Crisha-Pablo/Egal/gridfinity-rasierset/bilder/uebersicht.png

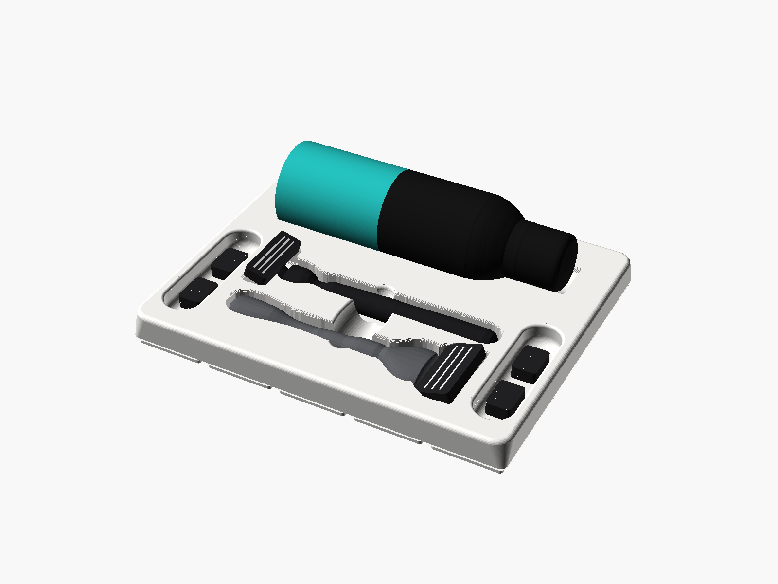
gridfinity-rasierset/bilder/uebersicht.png
