Crisha-Pablo/Egal/gridfinity-rasierset/stl/rasier_station_5x4x3u.stl

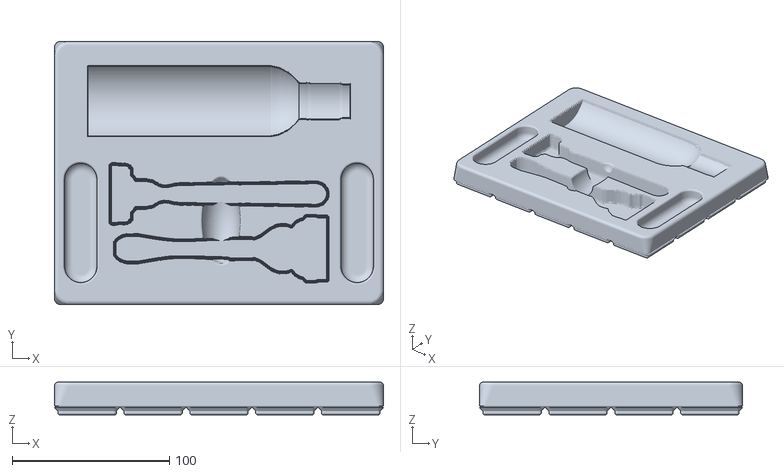
[picture p7: CAD file, 2026-10-03]
gridfinity-rasierset/stl/rasier_station_5x4x3u.stl
209.5 x 167.5 x 21.0
