Crisha-Pablo/Egal/gridfinity-rasierset/stl/passtest.stl

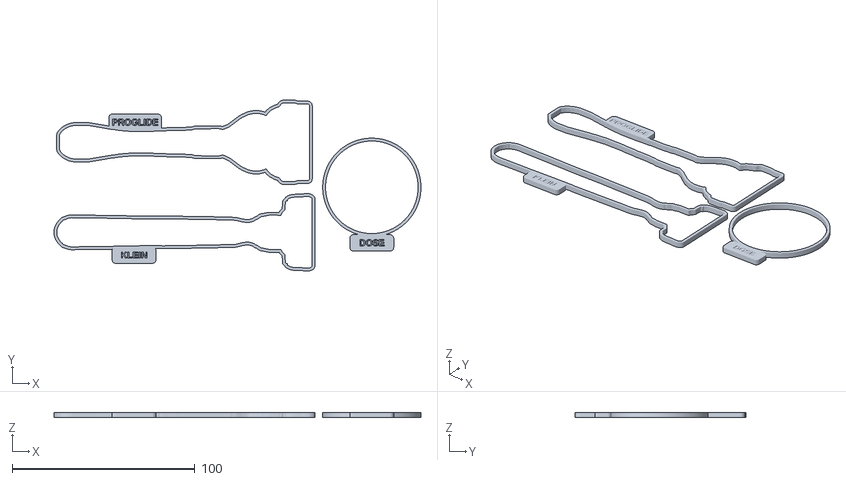
[picture p8: CAD file, 2026-10-03]
gridfinity-rasierset/stl/passtest.stl
200.8 x 93.5 x 3.00
