Crisha-Pablo/Egal/gridfinity-rasierset/umrisse.scad

// Automatisch erzeugt von werkzeug/fotos_vermessen.py. Nicht von Hand ändern.
// Alle Fotomaße gelten für 49 mm Dosendurchmesser, dose_d skaliert sie in OpenSCAD mit.

// Kleiner 3-Klingen-Rasierer aus IMG_8033: [Abstand vom Griffende, halbe Breite] in mm
bi_profil_mm = [
    [0.00, 0.00],
    [0.13, 1.66],
    [0.71, 3.02],
    [1.09, 3.68],
    [2.06, 4.92],
    [2.83, 5.52],
    [3.03, 5.97],
    [4.18, 6.32],
    [5.73, 6.94],
    [7.27, 7.17],
    [20.41, 6.93],
    [28.91, 6.88],
    [32.00, 6.74],
    [51.12, 6.45],
    [54.40, 6.53],
    [54.98, 6.41],
    [56.33, 6.41],
    [56.72, 6.58],
    [60.77, 6.50],
    [64.25, 6.54],
    [65.99, 6.42],
    [83.95, 6.15],
    [89.94, 5.96],
    [93.99, 5.99],
    [94.76, 5.86],
    [97.02, 5.76],
    [100.58, 4.87],
    [101.32, 4.81],
    [101.88, 4.64],
    [104.29, 4.55],
    [105.76, 4.90],
    [107.23, 5.37],
    [107.96, 5.76],
    [108.33, 6.16],
    [109.06, 6.35],
    [109.42, 6.55],
    [110.34, 7.20],
    [110.70, 7.33],
    [110.88, 7.60],
    [111.43, 7.86],
    [112.33, 7.92],
    [115.40, 8.56],
    [122.23, 8.52],
    [123.04, 10.19],
    [124.48, 11.71],
    [124.79, 11.89],
    [124.95, 16.31],
    [125.27, 16.32],
    [125.43, 16.46],
    [125.90, 16.49],
    [126.06, 17.50],
    [127.16, 18.07],
    [128.26, 18.34],
    [130.46, 18.50],
    [133.02, 18.52],
    [135.04, 18.75],
    [137.05, 18.73],
    [137.60, 18.50],
    [137.79, 18.33],
    [137.97, 18.33],
    [137.97, 0.00]];

bi_laenge_mm = 137.97;

// Rasierschaum-Dose aus IMG_8036: Länge / Durchmesser
dose_l_zu_d = 3.3429;

// Schulter und Kappe aus dem Produktbild: [Abstand von der Oberkante, Radius] in Dosendurchmessern
dose_oben = [
    [0.000, 0.088],
    [0.022, 0.265],
    [0.044, 0.299],
    [0.066, 0.314],
    [0.088, 0.319],
    [0.109, 0.321],
    [0.131, 0.321],
    [0.153, 0.321],
    [0.175, 0.321],
    [0.197, 0.321],
    [0.219, 0.321],
    [0.241, 0.321],
    [0.263, 0.321],
    [0.285, 0.321],
    [0.307, 0.321],
    [0.328, 0.321],
    [0.350, 0.321],
    [0.372, 0.321],
    [0.394, 0.321],
    [0.416, 0.321],
    [0.438, 0.321],
    [0.460, 0.321],
    [0.482, 0.321],
    [0.504, 0.325],
    [0.526, 0.325],
    [0.547, 0.323],
    [0.569, 0.323],
    [0.591, 0.323],
    [0.613, 0.323],
    [0.635, 0.325],
    [0.657, 0.347],
    [0.679, 0.365],
    [0.701, 0.381],
    [0.723, 0.398],
    [0.745, 0.412],
    [0.766, 0.425],
    [0.788, 0.436],
    [0.810, 0.445],
    [0.832, 0.456],
    [0.854, 0.464],
    [0.876, 0.473],
    [0.898, 0.480],
    [0.920, 0.485],
    [0.942, 0.489],
    [0.964, 0.493],
    [0.985, 0.496],
    [0.996, 0.500]];

// Gillette Fusion5 ProGlide aus dem Produktbild: [t, halbe Breite / Länge], t = 0 Griffende, 1 Kopfoberkante
pg_profil = [
    [0.0000, 0.0309],
    [0.0100, 0.0429],
    [0.0220, 0.0513],
    [0.0380, 0.0587],
    [0.0560, 0.0625],
    [0.1080, 0.0623],
    [0.2020, 0.0466],
    [0.2080, 0.0464],
    [0.2340, 0.0420],
    [0.2420, 0.0419],
    [0.2520, 0.0398],
    [0.2660, 0.0398],
    [0.2780, 0.0375],
    [0.3700, 0.0375],
    [0.3820, 0.0398],
    [0.4220, 0.0398],
    [0.4340, 0.0420],
    [0.5020, 0.0420],
    [0.5140, 0.0443],
    [0.5320, 0.0443],
    [0.5440, 0.0480],
    [0.5720, 0.0488],
    [0.6400, 0.0489],
    [0.6520, 0.0460],
    [0.6580, 0.0462],
    [0.6740, 0.0525],
    [0.6840, 0.0574],
    [0.6900, 0.0610],
    [0.7300, 0.0910],
    [0.7380, 0.0958],
    [0.7600, 0.1061],
    [0.7780, 0.1100],
    [0.8020, 0.1102],
    [0.8180, 0.1065],
    [0.8280, 0.1020],
    [0.8320, 0.1022],
    [0.8360, 0.1052],
    [0.8460, 0.1176],
    [0.8540, 0.1244],
    [0.8700, 0.1333],
    [0.8860, 0.1386],
    [0.8900, 0.1421],
    [0.8960, 0.1502],
    [0.9000, 0.1531],
    [0.9420, 0.1534],
    [0.9480, 0.1524],
    [0.9580, 0.1489],
    [1.0000, 0.1489]];
