Crisha-Pablo/Egal/(commit log)

2026-10-03 Add Gridfinity shaving set (lying, for drawers)
    Parametric OpenSCAD model plus ready-to-print STLs:
    - 5x2 cradle for the Gillette Shave Foam can (three support ribs)
    - 4x2 holder for Fusion5 ProGlide and GilletteLabs Body + Intimate,
    head to tail, with a finger notch
    - 2x3 holder for both plastic blade boxes
    - thin fit-test frames to check sizes before the big prints
    Grid sizes are computed from the product dimensions. Foot profile
    follows the Gridfinity spec (0.8 / 1.8 / 2.15 mm); all parts are
    single watertight solids and slice cleanly in PrusaSlicer.
    Claude-Session: https://claude.ai/code/session_01WwtDowKWmSpPsBrTGCSqi7
    [gridfinity_rasierset.scad, klingenbox_halter_2x3x3u.stl, passtest.stl, rasierer_halter_4x2x3u.stl, rasierschaum_wiege_5x2x4u.stl]
2026-10-03 Shape razor pockets and can cradle from measured outlines
    - Small 3-blade razor and the foam can are measured from the user's
    top-down iPhone photos. Scale comes from the 49 mm can diameter,
    carried to the razor photo via the remote's key spacing; perspective
    from the ~20 cm shooting distance is corrected per part height.
    - ProGlide outline comes from a product image; its length is still an
    estimate (pg_laenge).
    - Razor pockets follow the outlines with 0.8 mm clearance and interlock
    head to tail; the wall between them stays >= 1.9 mm at the top edge.
    - Can cradle gets end stops at the measured length.
    - dose_d scales every photo-derived size, the fit-test ring checks it.
    Co-Author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
    [gridfinity_rasierset.scad, klingenbox_halter_2x3x3u.stl, passtest.stl, rasierer_halter_4x2x3u.stl, rasierschaum_wiege_5x2x4u.stl, umrisse.scad]
2026-10-03 Merge the set into one Apple-style Gridfinity station
    - One 5x4x3u part instead of three: can trough at the back, both
    razors head to tail in front, a blade compartment on each side.
    - Blade box holders are gone (their sizes were guesses); the two
    compartments take loose cartridges.
    - Soft look: 9 mm top corners, 2.5 mm rounded top edge, 1 mm shadow
    gap above the baseplate, 1.5 mm rounds on every pocket rim,
    filleted pocket floors, oval finger scoop under both handles.
    - Can trough is a solid of revolution of the measured can profile.
    - Rounds on non-convex outlines are stepped at one layer height
    (schicht); convex pockets are built from hulls, so prints show no
    terraces.
    - werkz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
    [gridfinity_rasierset.scad, klingenbox_halter_2x3x3u.stl, passtest.stl, rasier_station_5x4x3u.stl, rasierer_halter_4x2x3u.stl, rasierschaum_wiege_5x2x4u.stl]
2026-10-03 Add studio renders of the station
    White hero shot, top view, parts floating above their pockets and the
    empty station in space grey, rendered with werkzeug/rendern.py
    (Blender Cycles, 256 samples).
    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
